jacopods98/BOX/HiroseHR30/plug.pdf

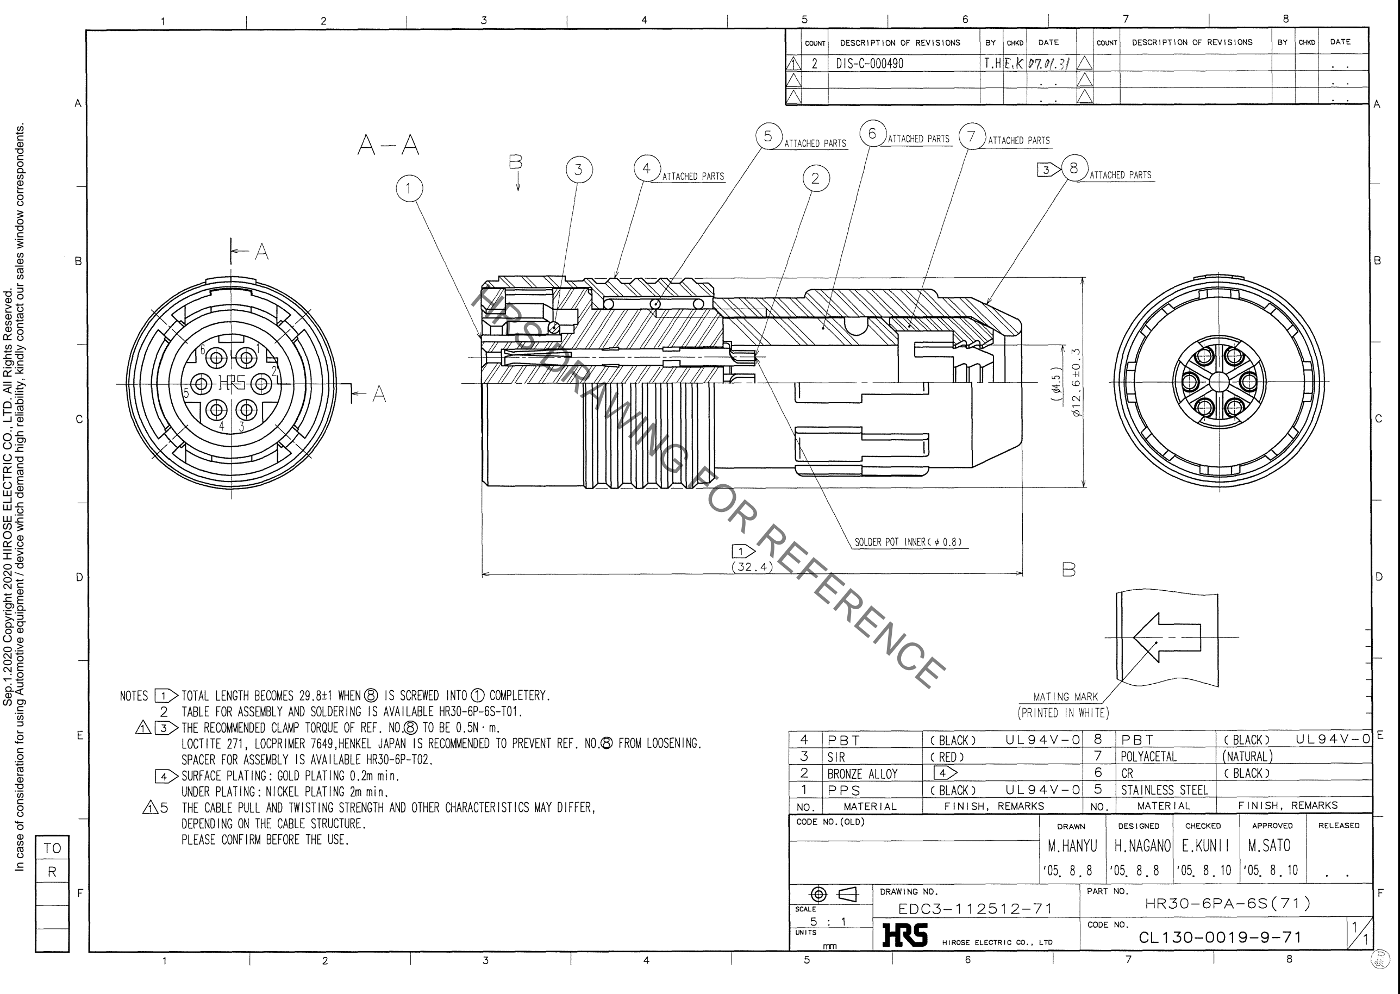
[picture p1: page 1]

HRS DRAWING FOR REFERENCE
