jacopods98/BOX/HiroseHR30/receptacle.pdf

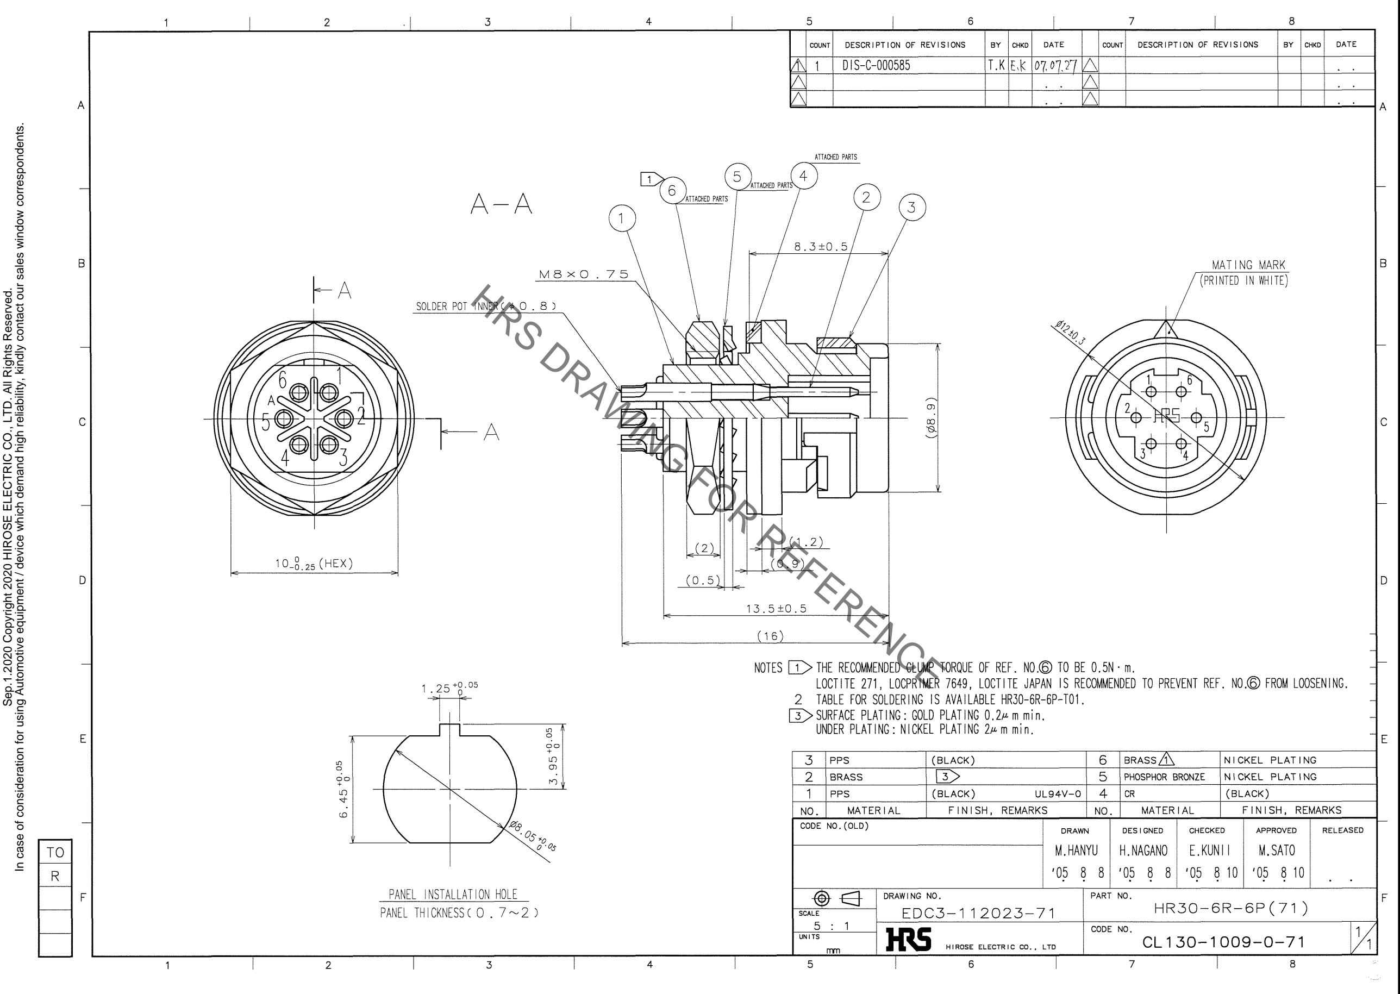
[picture p2: page 1]

HRS DRAWING FOR REFERENCE
