jacopods98/BOX/BNC/BNC_connectors.stp

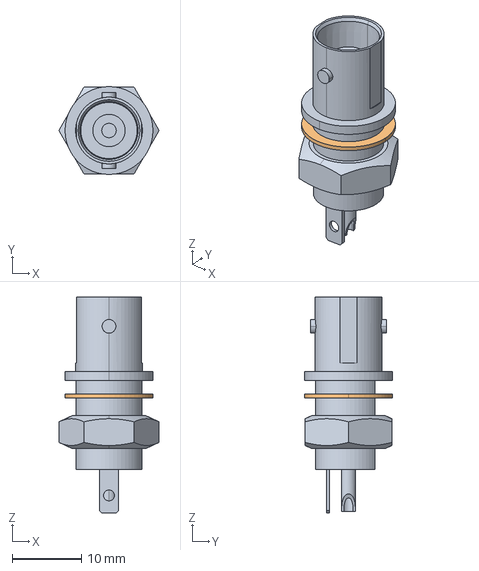
[picture p3: CAD file, 2022-05-11]
BNC/BNC_connectors.stp
14.5 x 12.7 x 31.2 mm
