jacopods98/BOX/Inventor/Bottom-02062022.stp

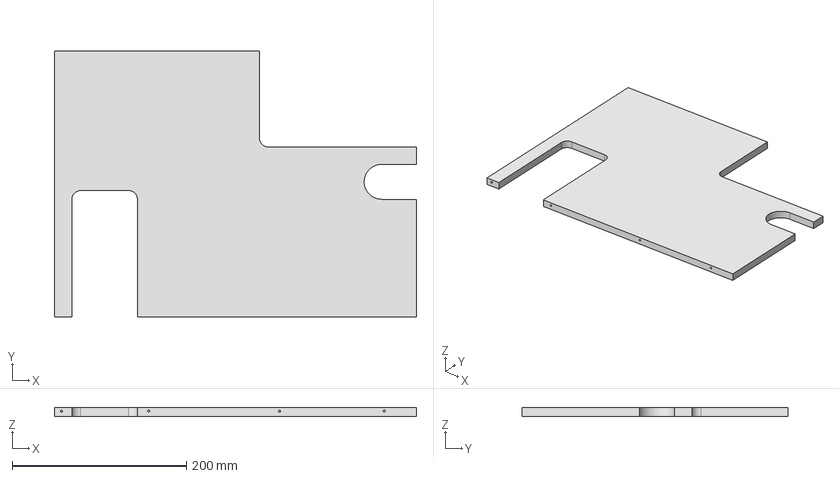
[picture p4: CAD file, 2022-06-08]
Inventor/Bottom-02062022.stp
415.0 x 305.0 x 10.0 mm
