jacopods98/BOX/tiny-XLR/tiny_xlr.STP

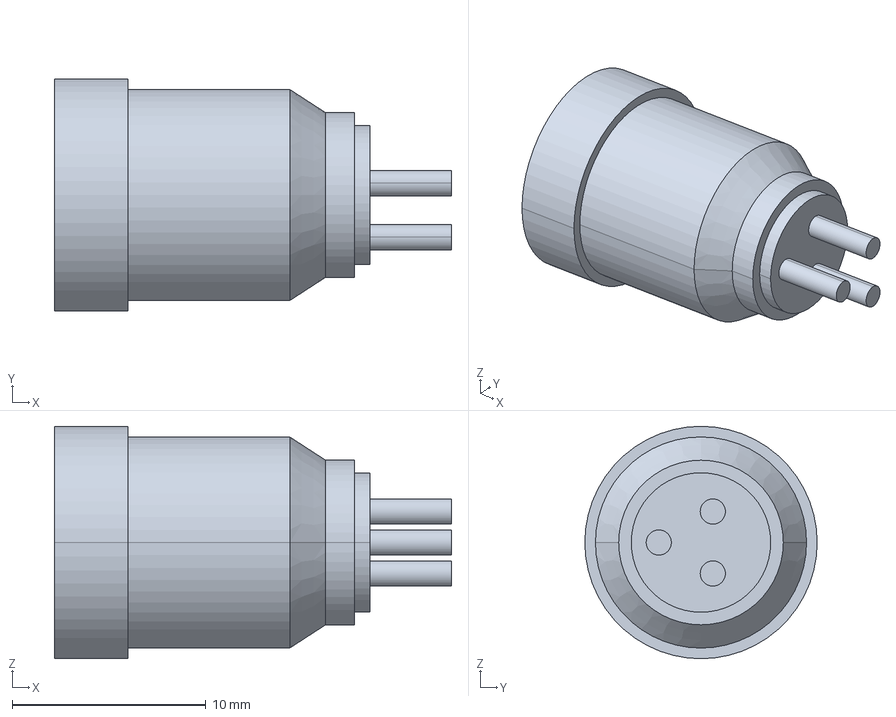
[picture p5: CAD file, 2022-05-11]
tiny-XLR/tiny_xlr.STP
20.5 x 12.0 x 12.0 mm
