jacopods98/BOX/Inventor/BackPanel.stp

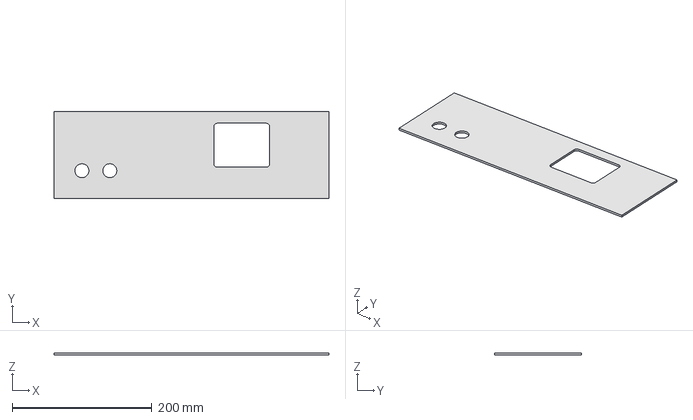
[picture p6: CAD file, 2022-06-08]
Inventor/BackPanel.stp
394.0 x 125.0 x 3.00 mm
