jacopods98/BOX/Inventor/FrontPanel-03062022.stp

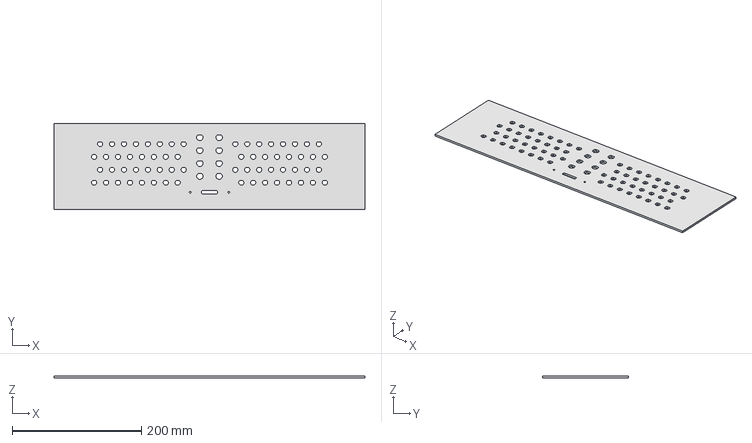
[picture p7: CAD file, 2022-06-08]
Inventor/FrontPanel-03062022.stp
482.0 x 133.0 x 3.00 mm
