jacopods98/BOX/(list of files, cad)

Other CAD files:
Inventor/Bottom.stp
Inventor/FrontPanel.stp
Inventor/FrontPanel-02062022.stp
Inventor/BackPanel-02062022.stp
BNC/BNC_connectors.ipt
Inventor/BackPanel.idw
Inventor/BackPanel.ipt
Inventor/Bottom.idw
Inventor/Bottom.ipt
Inventor/FrontPanel.idw
Inventor/FrontPanel.ipt
tiny-XLR/tini_xlr.idw
tiny-XLR/tiny_xlr.ipt
