jacopods98/BOX/tiny-XLR/tiny_xlr.pdf

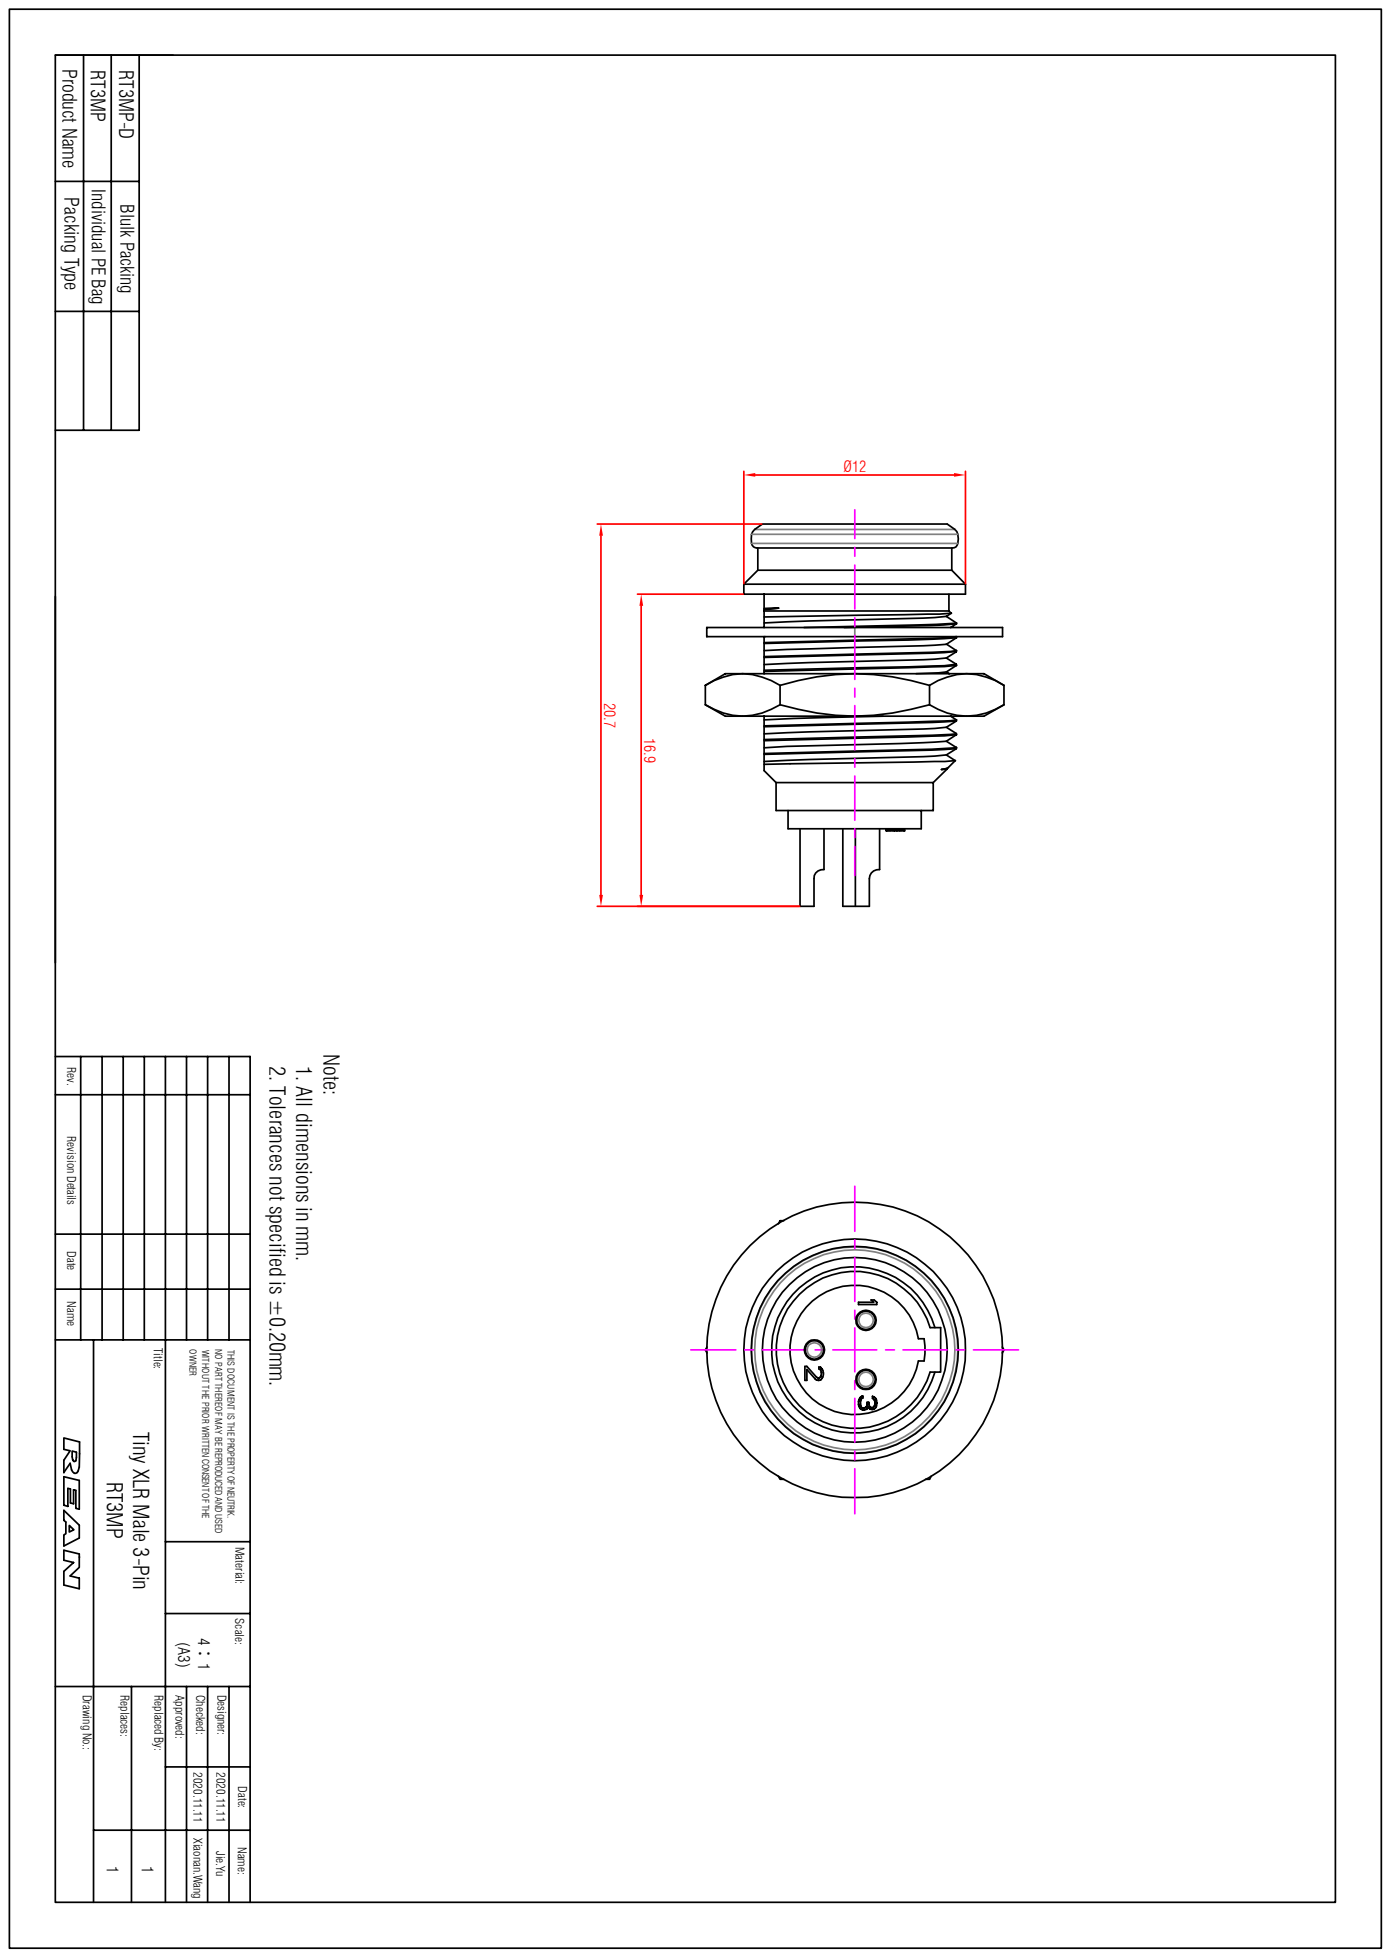
[picture p8: page 1]
Ø12 16.9 20.7 Product Name; RT3MP-D Blulk Packing Packing Type; Individual PE Bag

Tiny XLR Male 3-Pin RT3MP 4∶1 (A3) 11 OWNER WITHOUT THE PRIOR WRITTEN CONSENT OF THE NO PART THEREOF MAY BE REPRODUCED AND USED THIS DOCUMENT IS THE PROPERTY OF NEUTRIK. Material: Scale: Title: Date: Approved: Checked: Designer: 2020.11.11 2020.11.11 Jie.Yu Xiaonan.Wang Drawing No.: Replaces: Replaced By: Name Date Revision Details Rev. Name: 2. Tolerances not specified is ±0.20mm. 1. All dimensions in mm. Note:
