jacopods98/BOX/Inventor/BackPanel-02062022.pdf

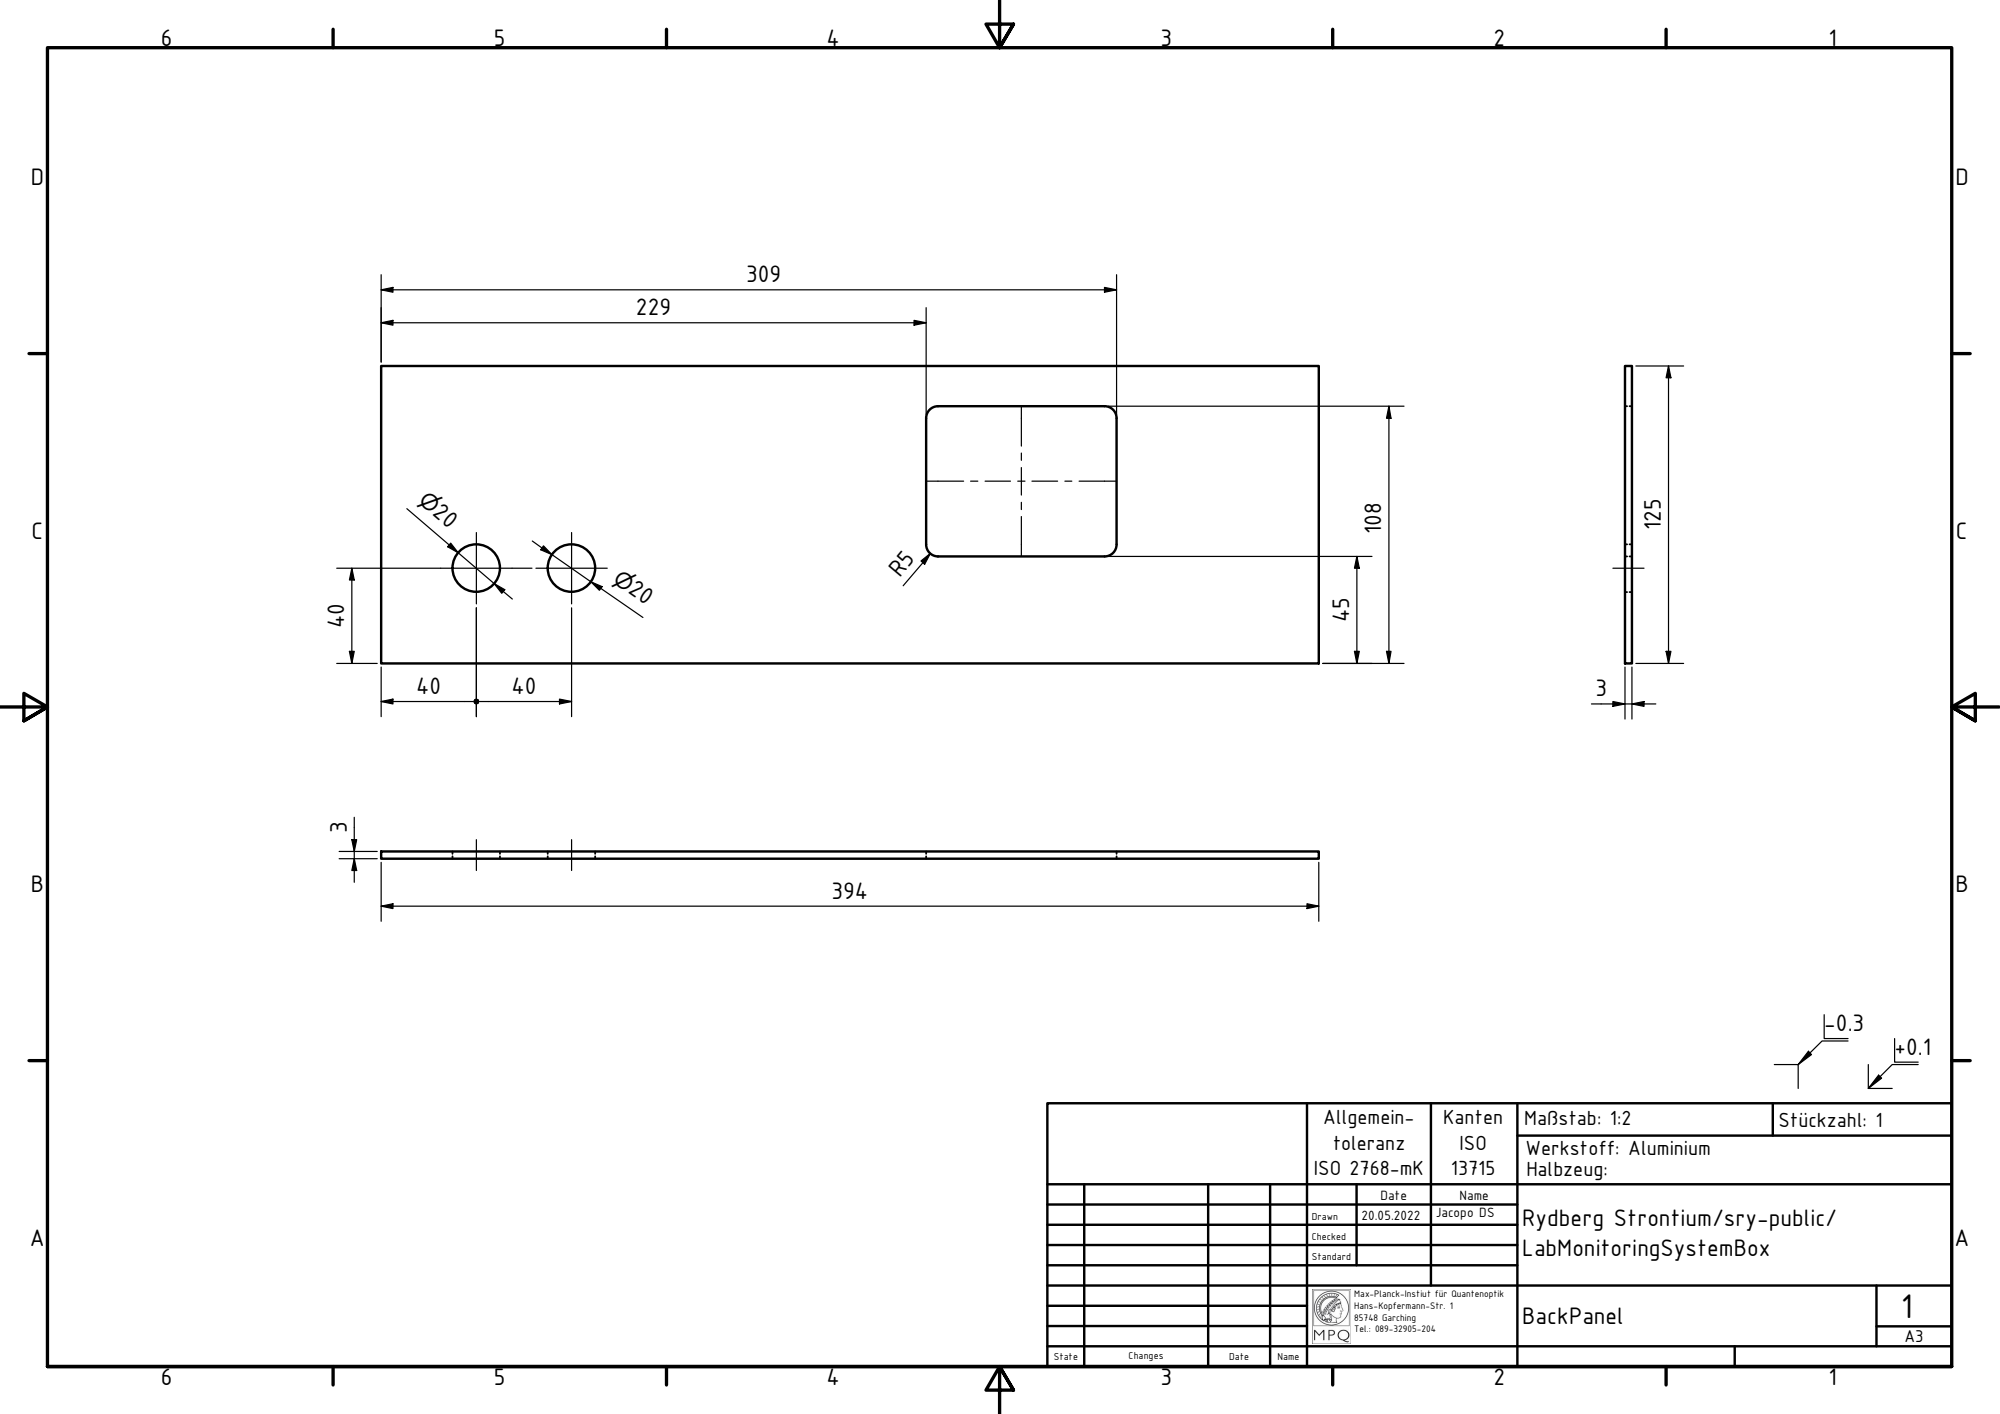
[picture p9: page 1]
ISO 2768-mK; Maßstab: 1:2; Stückzahl: 1; Werkstoff: Aluminium

Date | Name | Rydberg Strontium/sry-public/ LabMonitoringSystemBox

Drawn | 20.05.2022 | Jacopo DS

Checked

Standard

Max-Planck-Instiut für Quantenoptik
Hans-Kopfermann-Str. 1
85748 Garching
Tel.: 089-32905-204
