jacopods98/BOX/Inventor/BackPanel.pdf

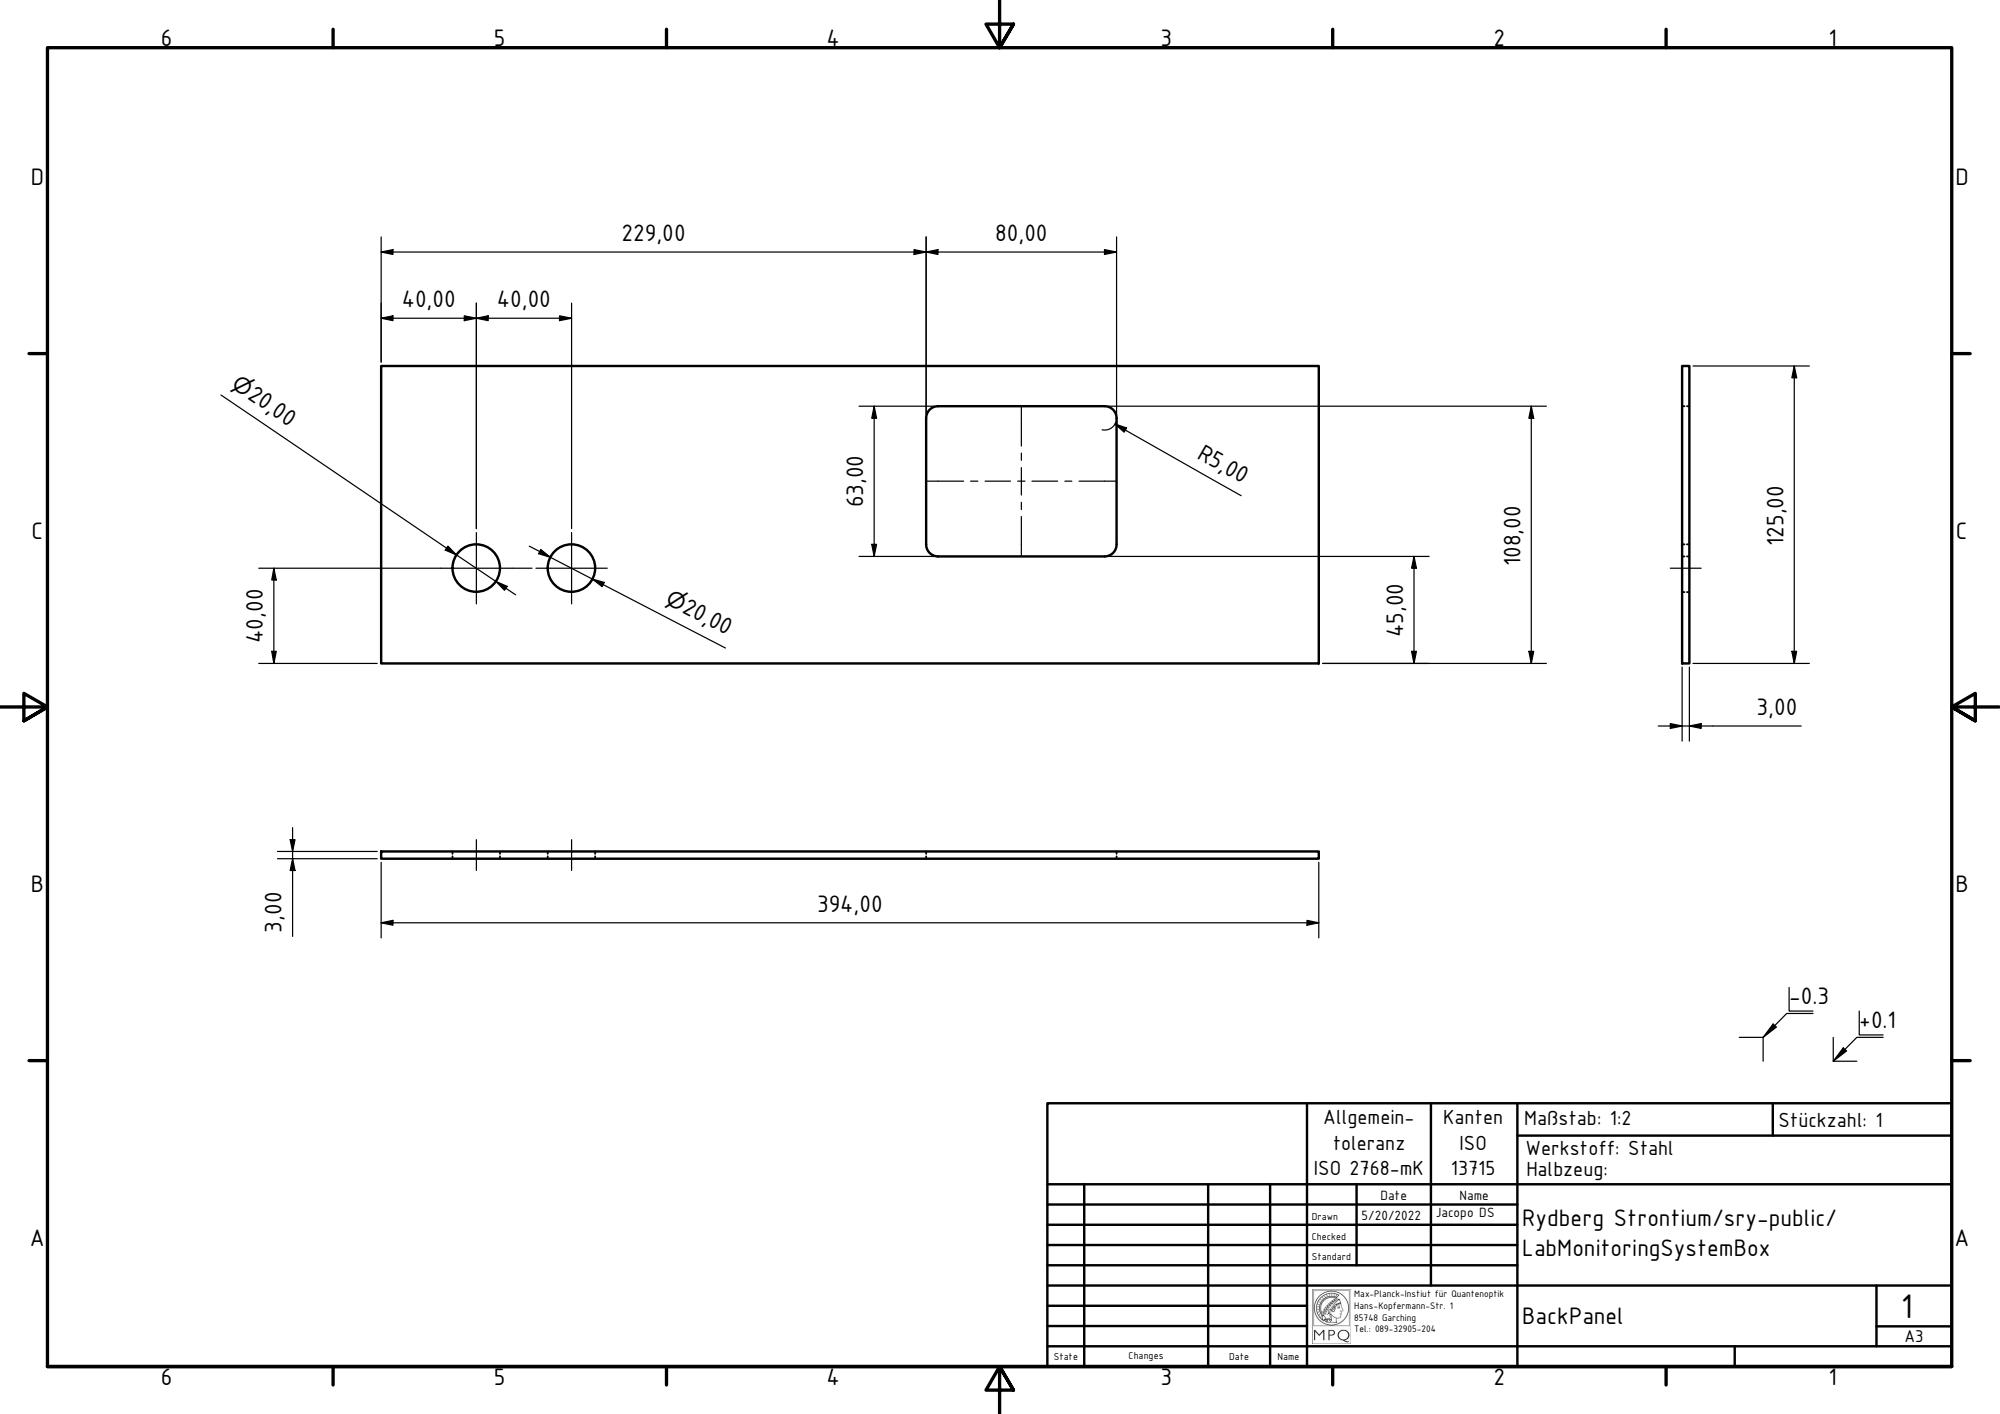
[picture p10: page 1]
ISO 2768-mK; Maßstab: 1:2; Stückzahl: 1; Werkstoff: Stahl

Date | Name | Rydberg Strontium/sry-public/ LabMonitoringSystemBox

Drawn | 5/20/2022 | Jacopo DS

Checked

Standard

Max-Planck-Instiut für Quantenoptik
Hans-Kopfermann-Str. 1
85748 Garching
Tel.: 089-32905-204
