jacopods98/BOX/Inventor/Bottom-02062022.pdf

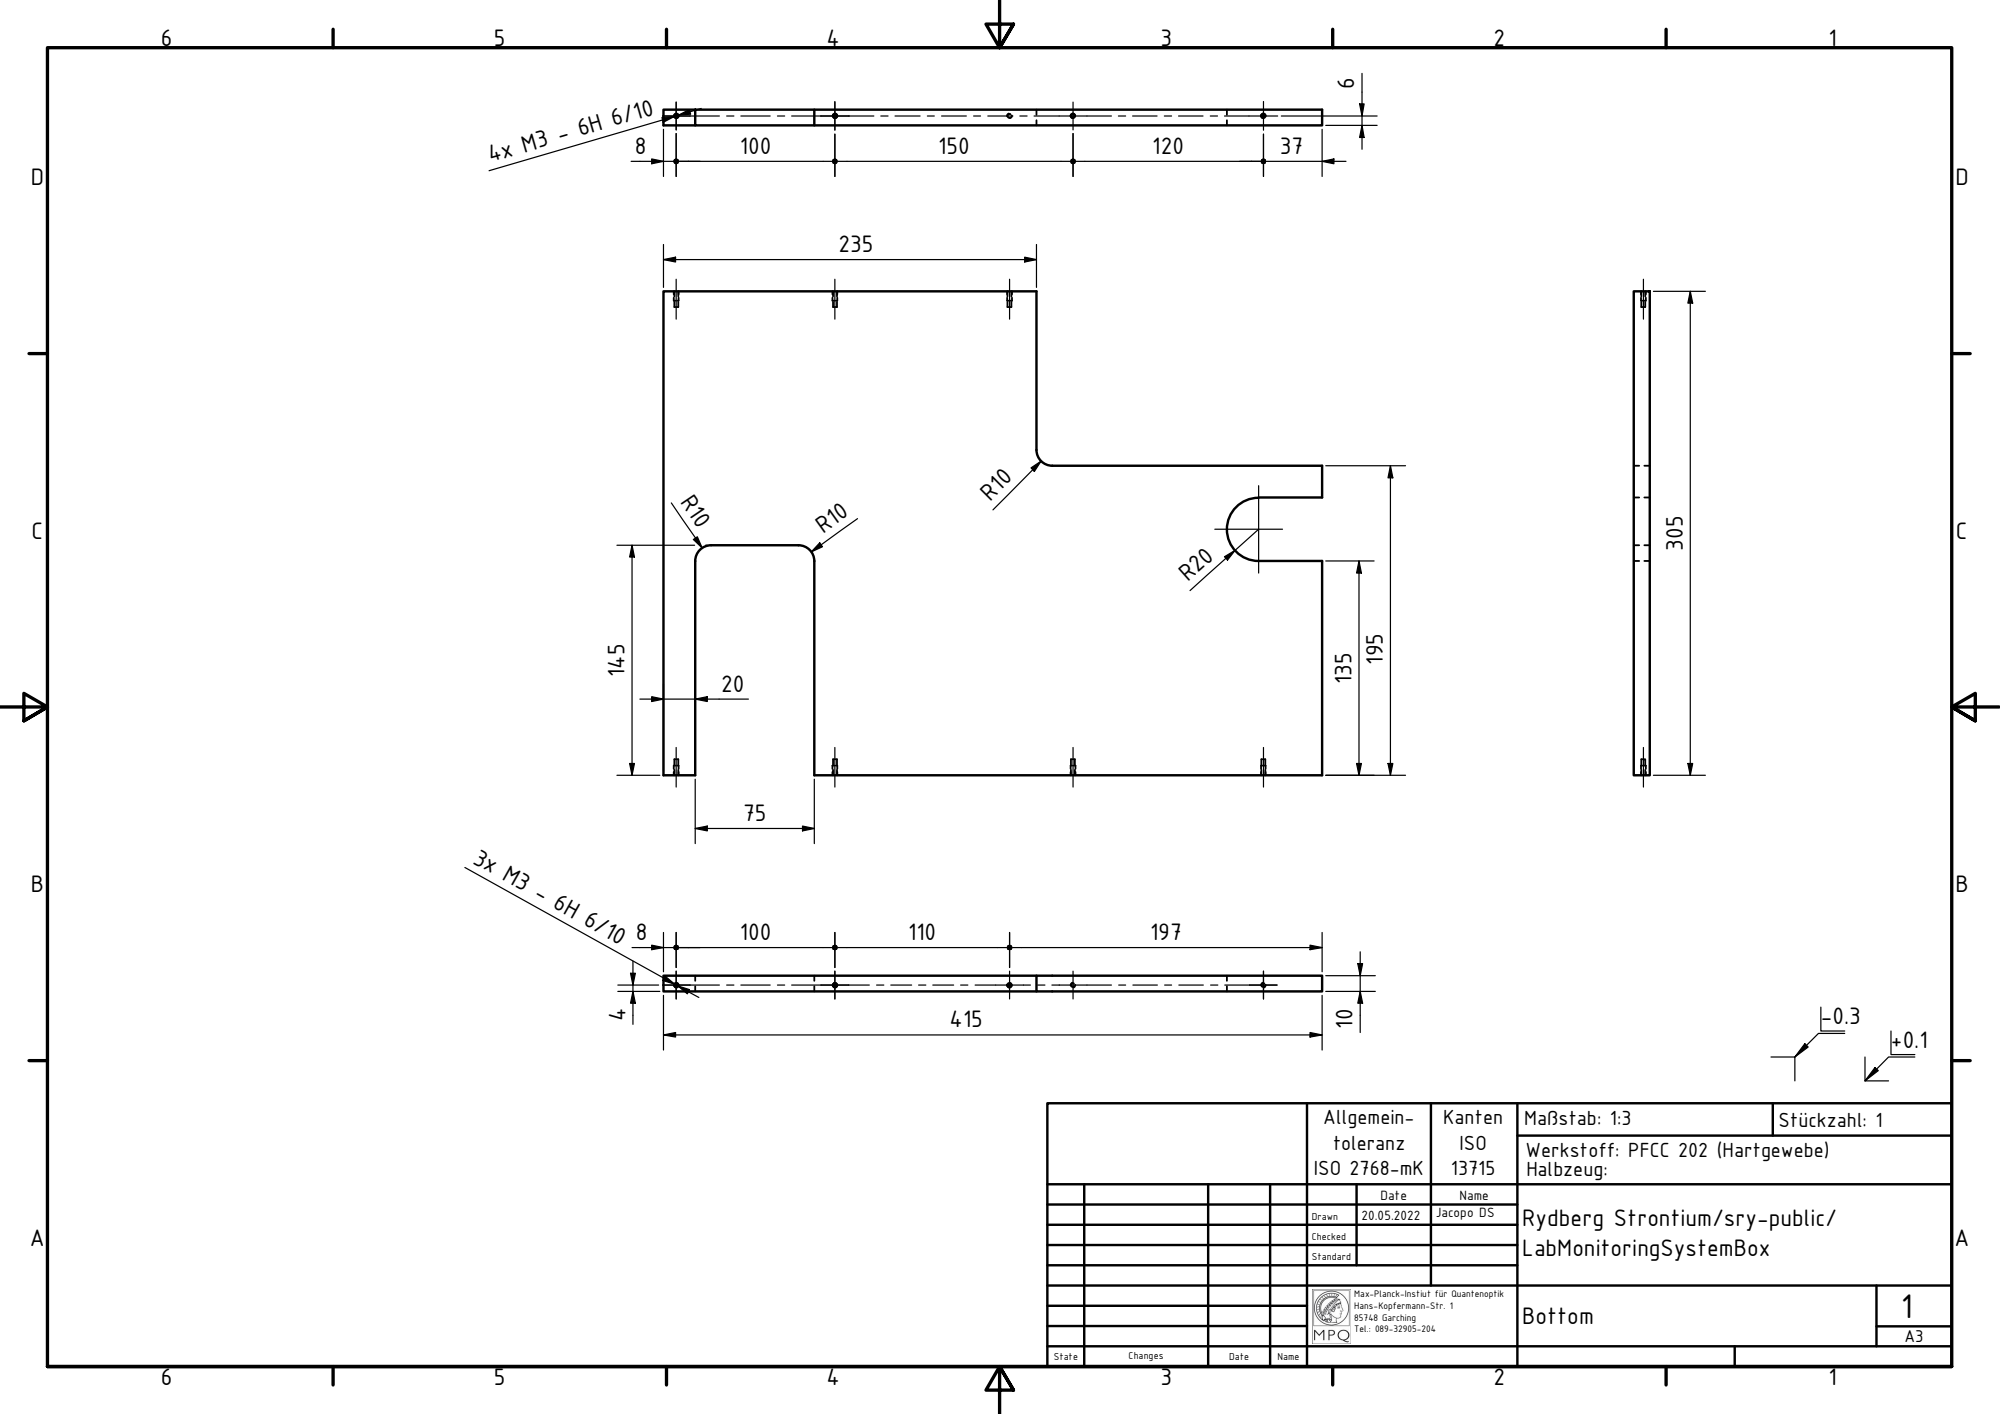
[picture p11: page 1]
ISO 2768-mK; Maßstab: 1:3; Stückzahl: 1

Werkstoff: PFCC 202 (Hartgewebe)
Halbzeug:

Date | Name | Rydberg Strontium/sry-public/ LabMonitoringSystemBox

Drawn | 20.05.2022 | Jacopo DS

Checked

Standard

Max-Planck-Instiut für Quantenoptik
Hans-Kopfermann-Str. 1
85748 Garching
Tel.: 089-32905-204
