jacopods98/BOX/Inventor/Bottom.pdf

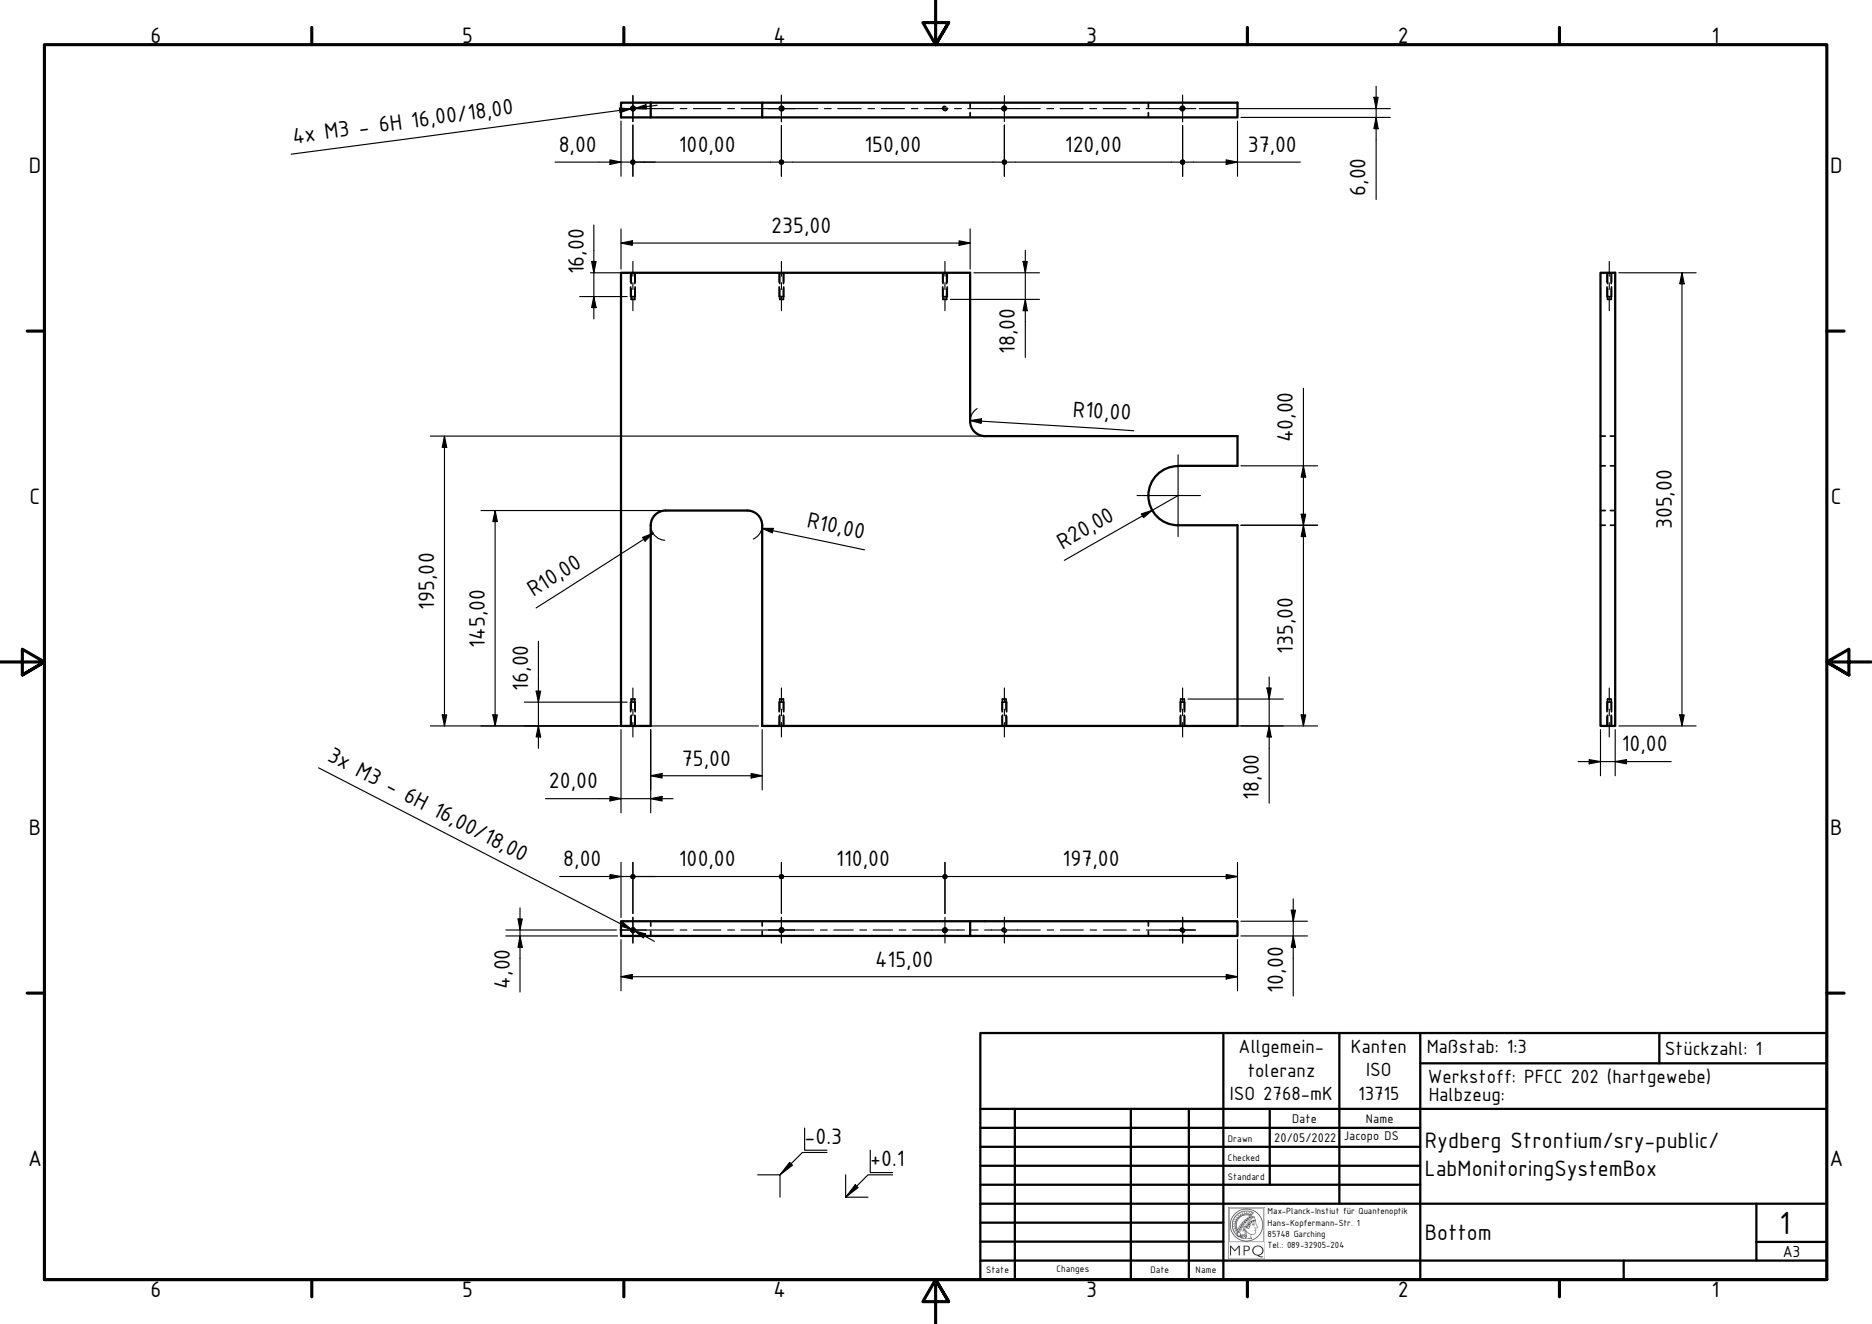
[picture p12: page 1]
Jacopo DS; ISO 2768-mK; Maßstab: 1:3; Stückzahl: 1

Werkstoff: PFCC 202 (hartgewebe)
Halbzeug:

Rydberg Strontium/sry-public/
LabMonitoringSystemBox

Max-Planck-Instiut für Quantenoptik
Hans-Kopfermann-Str. 1
85748 Garching
Tel.: 089-32905-204
