jacopods98/BOX/Inventor/FrontPanel-02062022.pdf

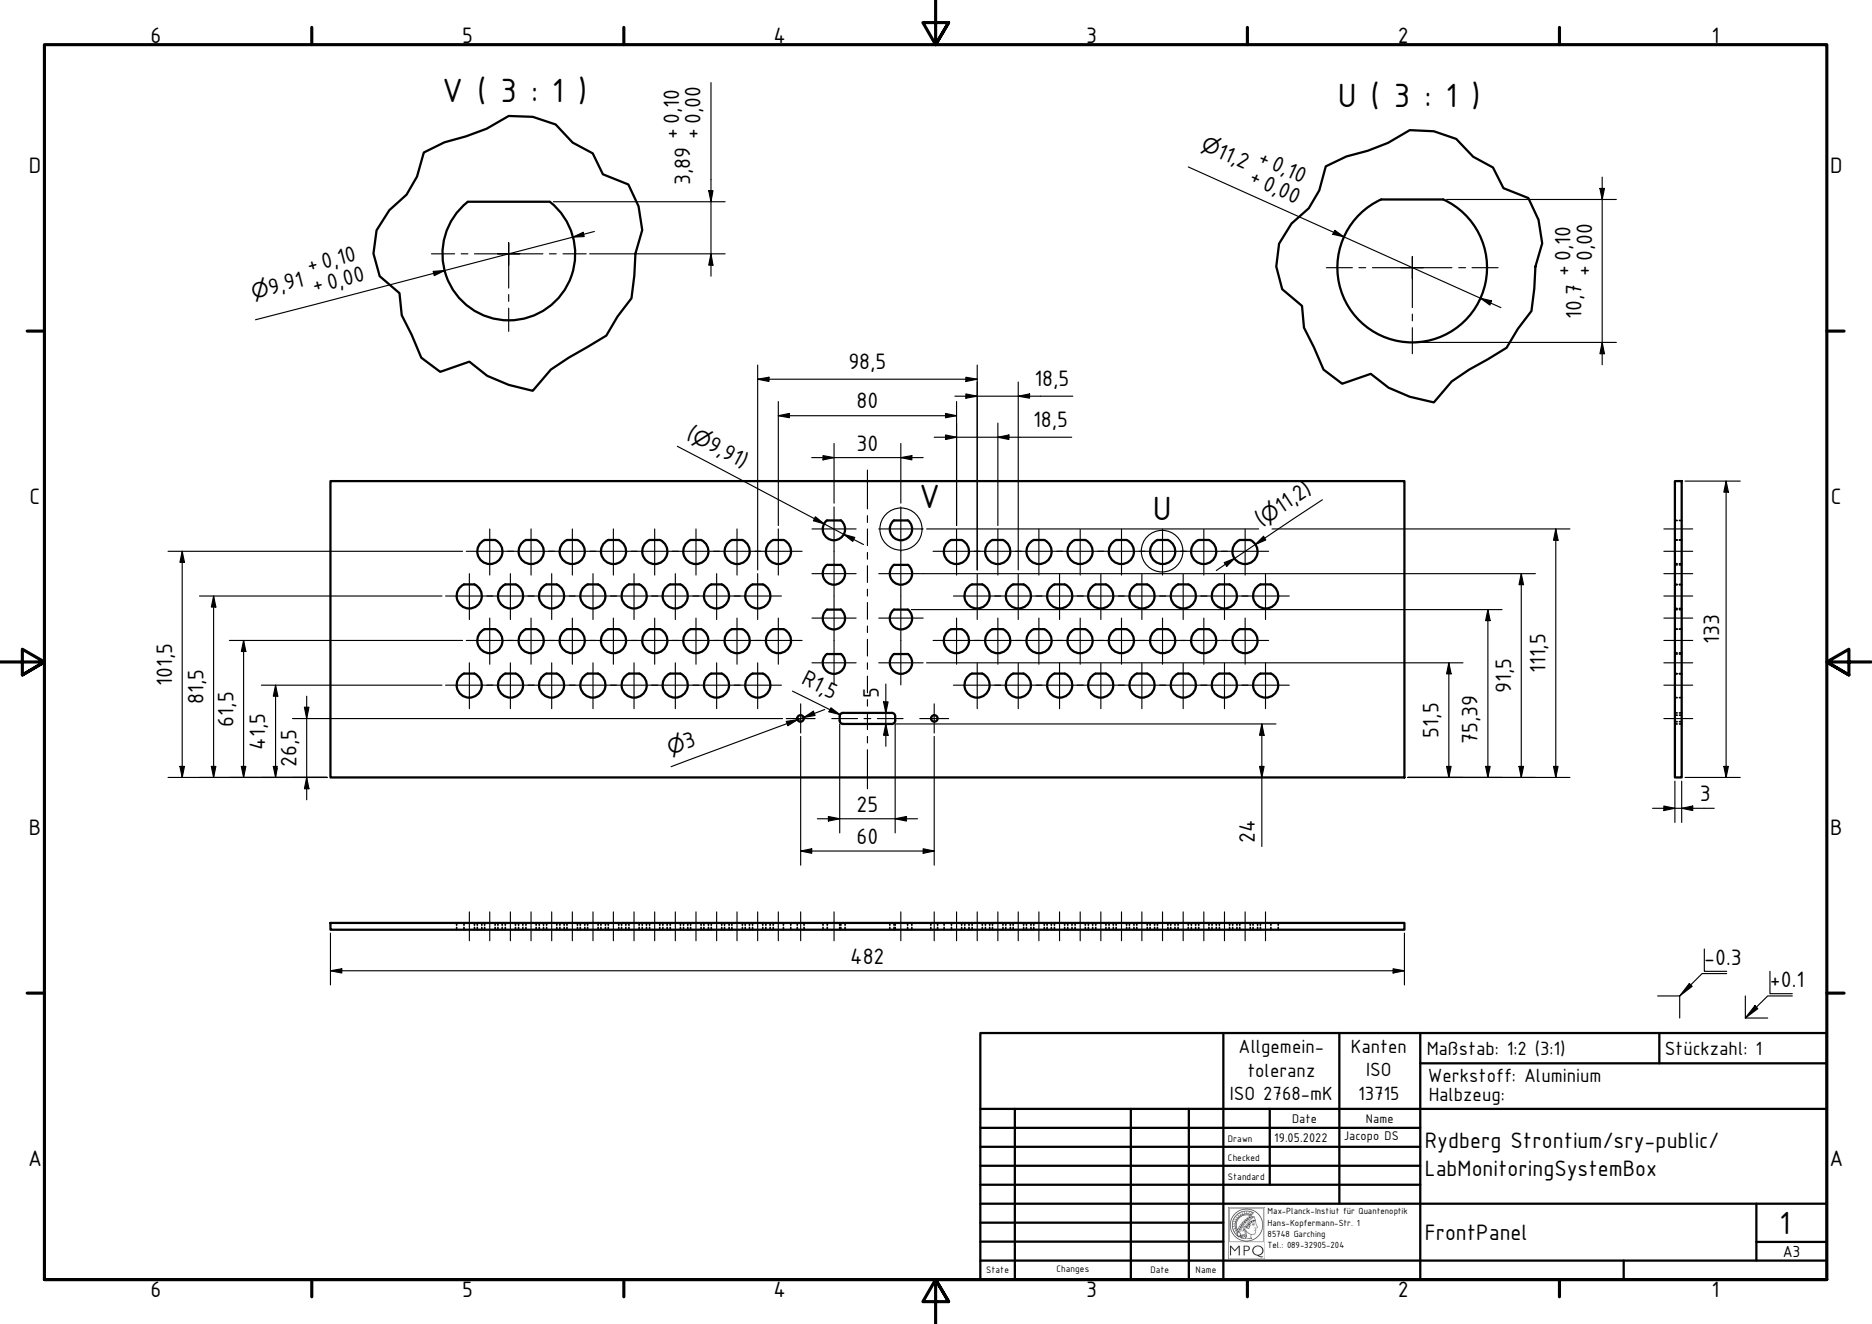
[picture p13: page 1]
n ISO; z ISO 2768-m

D r a w n | 1 9.0 5.2 0 2 2 | J a c o p o D S | g: Max-Planck-Instiut für Quantenoptik Hans-Kopfermann-Str. 1 85748 Garching Tel.: 089-32905-204

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
