jacopods98/BOX/BNC/BNC_connectors.pdf

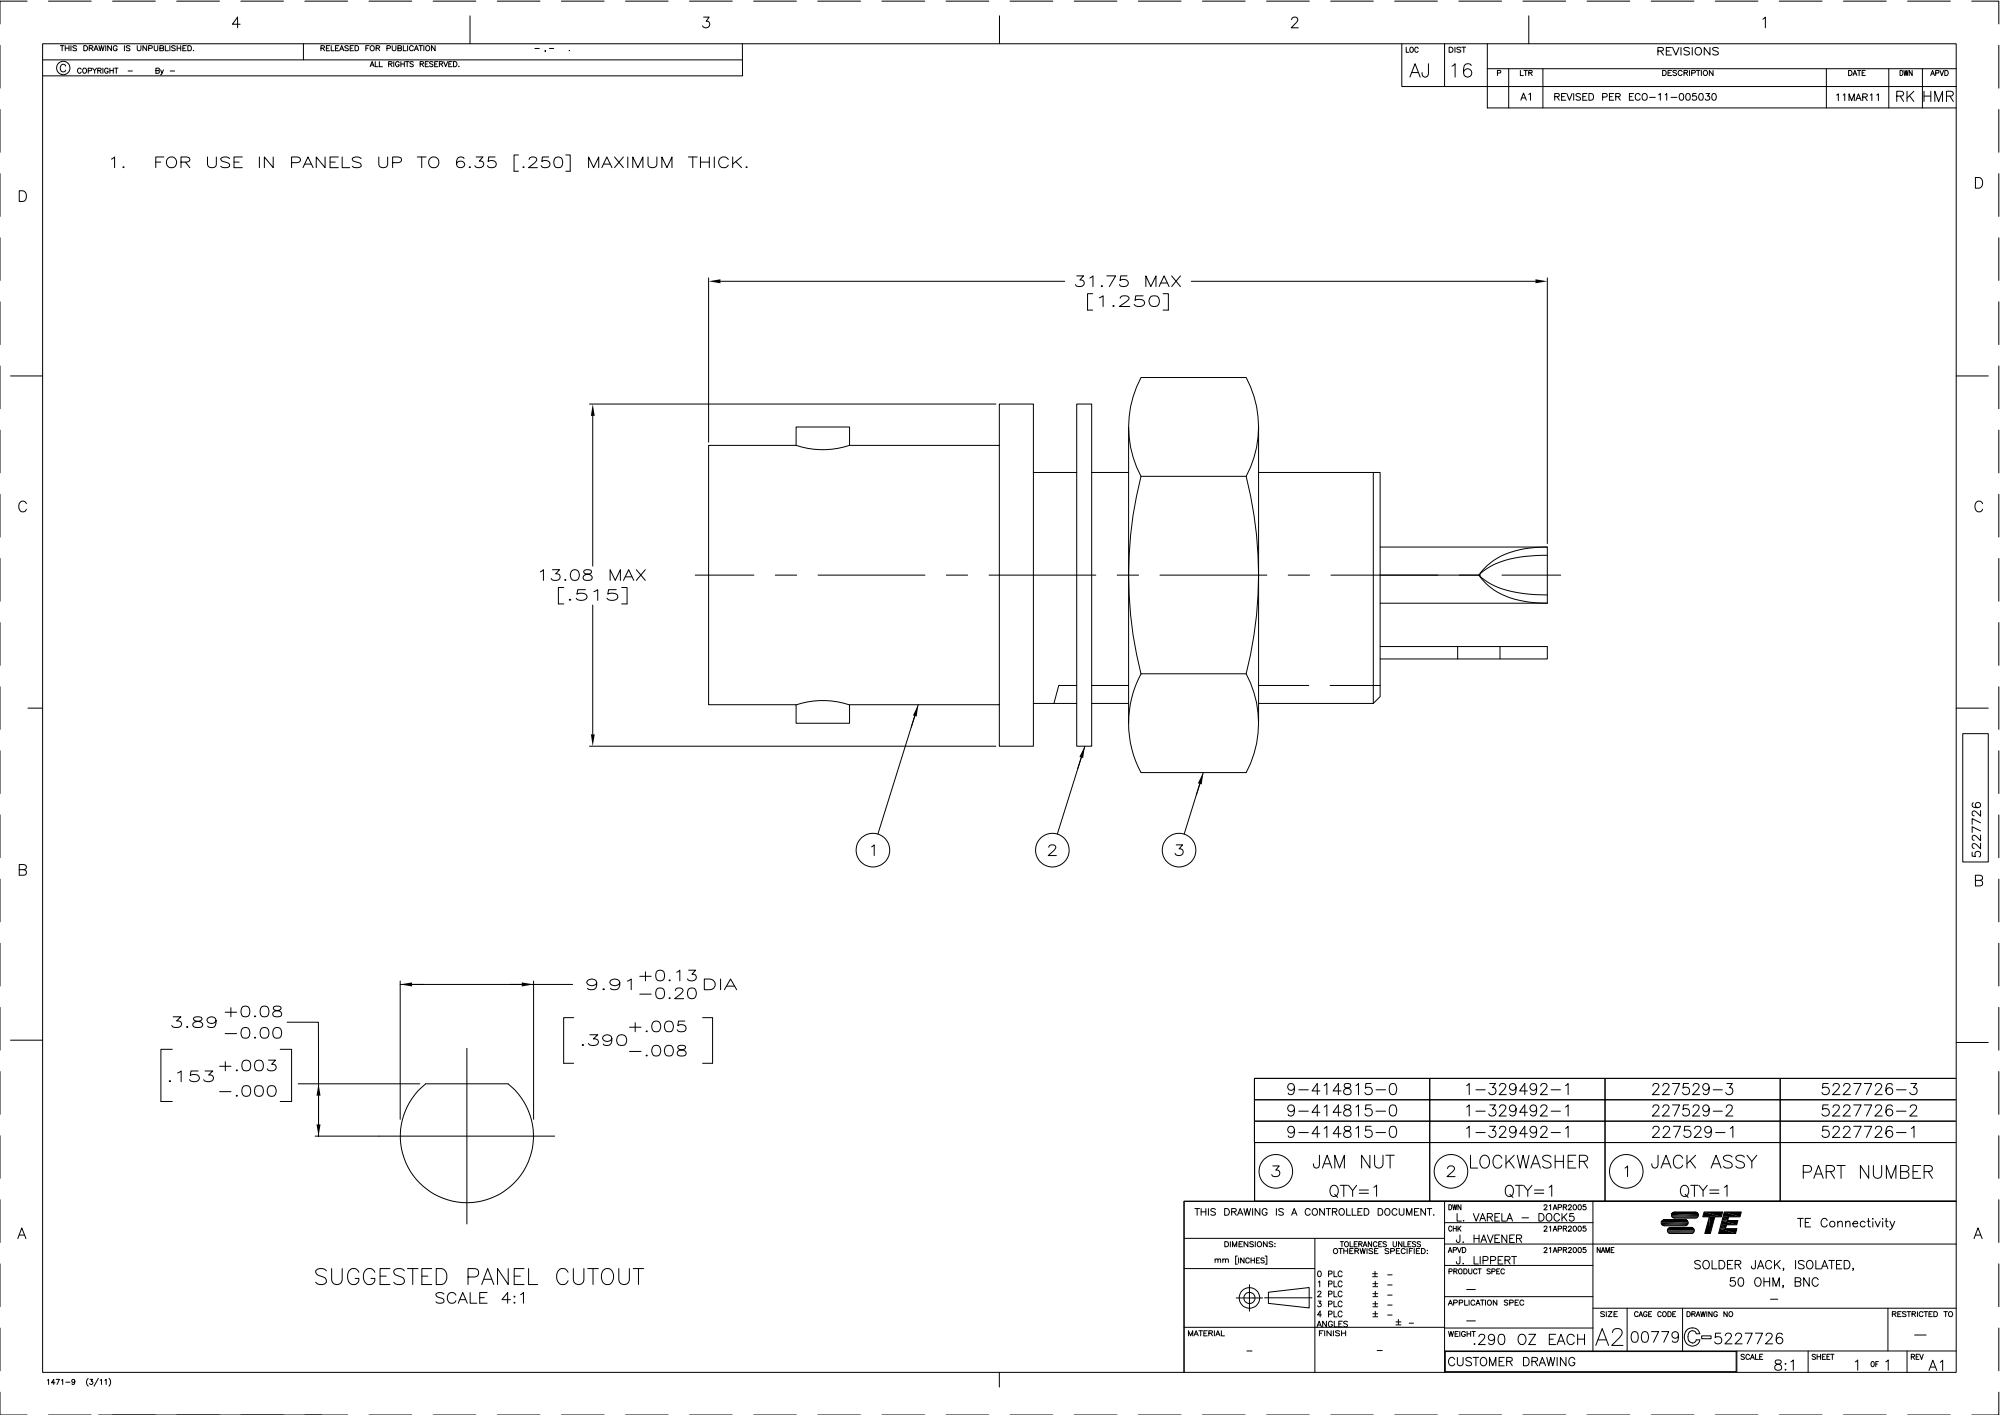
[picture p14: page 1]
