jacopods98/BOX/(commit log)

2022-05-11 BNC and A/D inputs
    [BNC_connectors.stp, Front Panel.0014.ipt, Front Panel.ipt, tini_xlr.idw, tiny_xlr.STP, tiny_xlr.ipt]
2022-05-11 all connectors missing buzzer
    [Front Panel.0014.ipt, Front Panel.0016.ipt, Front Panel.ipt]
2022-05-13 sketch finished
    [Front Panel.0016.ipt, Front Panel.0021.ipt, Front Panel.ipt]
